pbystrup/EU1KY-Vector-Network-Analyzer/754926017-RF_FE_V3.png

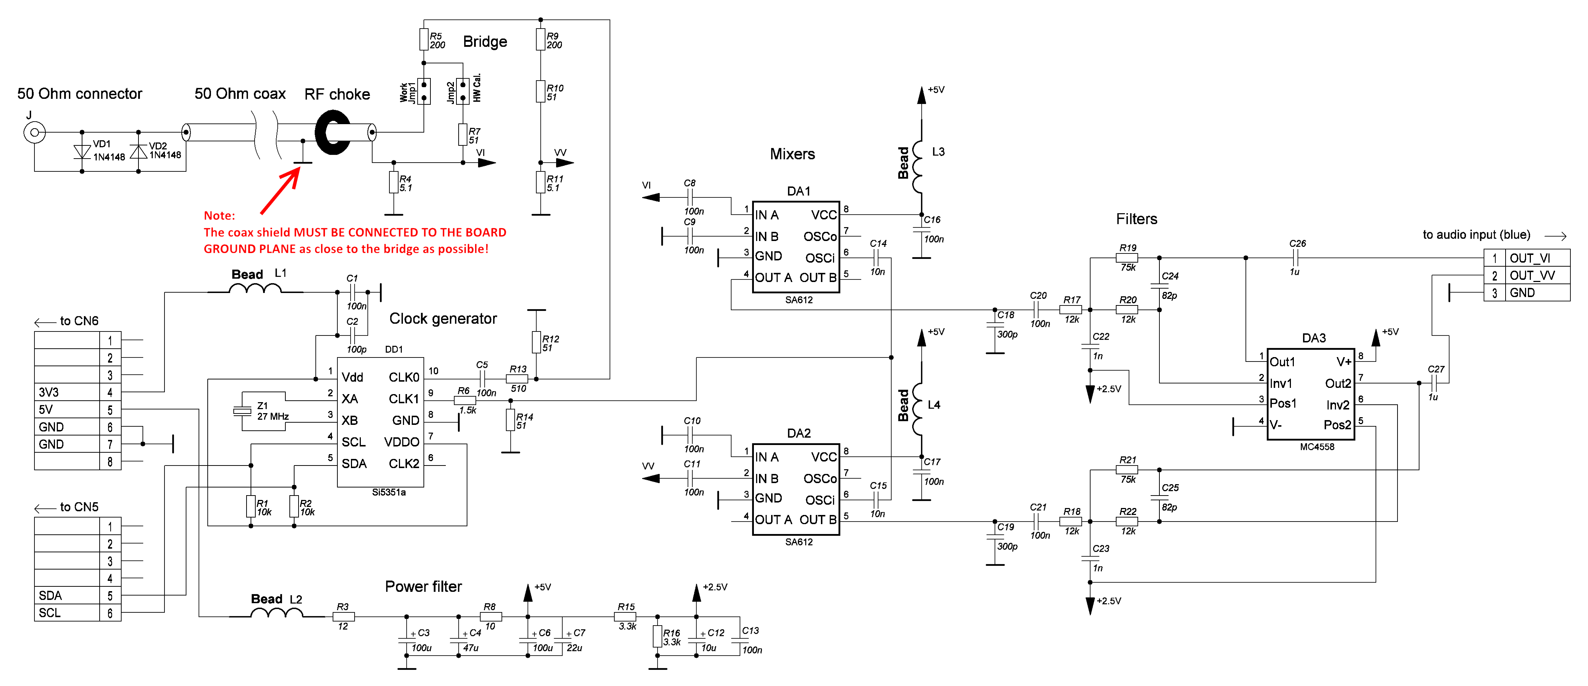
754926017-RF_FE_V3.png
