pbystrup/EU1KY-Vector-Network-Analyzer/EU1KY_V3_assy.gif

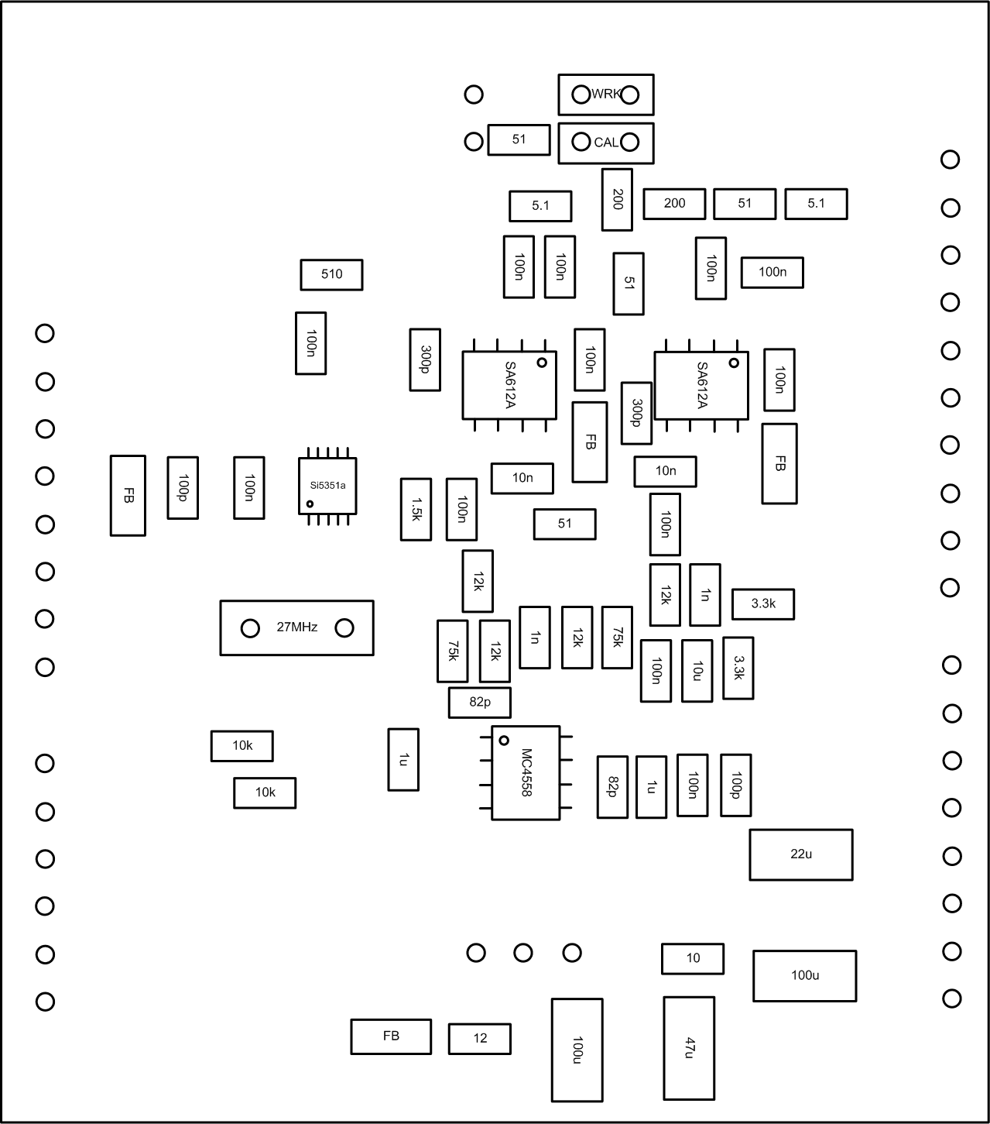
EU1KY_V3_assy.gif
