pbystrup/EU1KY-Vector-Network-Analyzer/RF_FE_V3  by YL2GL no trueholecaps xy all805 BOM.xlsx

BOM
Manufacturer | Manufacturer Part Number | Designator | Qty | Description | Case | SMD ,BGA,LLC(QFN),OR TH | Top/Bottom | points | Total points | Notes | Comments
AVX Corporation | 08055C104KAT2A | C1, C5, C8, C9, C10, C11, C13, C16, C17, C20, C21, C28 | 12 | 100nF,50V,10%,X7R,0805 | 0805 | SMD | Top | 2 | 24
AVX Corporation | 08055A101JAT2A | C2, C29 | 2 | 100pF,50V,5%,C0G,0805 | 0805 | SMD | Top | 2 | 4
AVX Corporation | TAJB107M010RNJ | C3, C6 | 2 | 100uF,10V,20%,1210(B) | 1210(B) | SMD | Top | 2 | 4
AVX Corporation | TAJB476M010RNJ | C4 | 1 | 47uF,10V,20%,1210(B) | 1210(B) | SMD | Top | 2 | 2
AVX Corporation | TAJB226M010RNJ | C7 | 1 | 22uF,10V,20%,1210(B) | 1210(B) | SMD | Top | 2 | 2
MULTICOMP | MC0805X106K100CT | C12 | 1 | 10uF,10V,10%,X5R,0805 | 0805 | SMD | Top | 2 | 2
AVX Corporation | 08055C103KAT2A | C14, C15 | 2 | 10nF,50V,10%,X7R,0805 | 0805 | SMD | Top | 2 | 4
AVX Corporation | 08055A331JAT2A | C18, C19 | 2 | 330pF,50V,5%,C0G,0805 | 0805 | SMD | Top | 2 | 4
AVX Corporation | 08055C102KAT2A | C22, C23 | 2 | 1nF,50V,10%,X7R,0805 | 0805 | SMD | Top | 2 | 4 | Please kindly check it should be 10nF or 1nF.
AVX Corporation | 08055A820JAT2A | C24, C25 | 2 | 82pF,50V,5%,C0G,0805 | 0805 | SMD | Top | 2 | 4
AVX Corporation | 08055C105KAT2A | C26, C27 | 2 | 1uF,50V,10%,X7R,0805 | 0805 | SMD | Top | 2 | 4
NXP Semiconductors | SA612AD/01,118 | DA1, DA2 | 2 | SA612AD/01,118,8-SO | 8-SO | SMD | Top | 8 | 16 | OK?
STMicroelectronics | MC4558CDT | DA3 | 1 | MC4558CDT,SO-8 | SO-8 | SMD | Top | 8 | 8
Silicon Laboratories | SI5351A-B-GT | DD1 | 1 | SI5351A-B-GT,MSOP-10 | MSOP-10 | SMD | Top | 10 | 10
Fair-Rite | 2508056017Y2 | L1, L2, L3, L4 | 4 | 600R,2A,0805 | 0805 | SMD | Top | 2 | 8
MULTICOMP | MCWR08X1002FTL | R1, R2 | 2 | 10K,1%,1/8W,0805 | 0805 | SMD | Top | 2 | 4
Panasonic | ERJ-P06J120V | R3 | 1 | 12R,5%,1/2W,0805 | 0805 | SMD | Top | 2 | 2 | OK?
MULTICOMP | MCWR08W5R10FTL | R4, R11 | 2 | 5.1R,1%,1/8W,0805 | 0805 | SMD | Top | 2 | 4
MULTICOMP | MCWR08X2000FTL | R5, R9 | 2 | 200R,1%,1/8W,0805 | 0805 | SMD | Top | 2 | 4
MULTICOMP | MCWR08X1501FTL | R6 | 1 | 1.5K,1%,1/8W,0805 | 0805 | SMD | Top | 2 | 2 | Please kindly check it should be 1 or 2.
MULTICOMP | MCWR08X51R0FTL | R7, R10, R12, R14 | 4 | 51R,1%,1/8W,0805 | 0805 | SMD | Top | 2 | 8
Panasonic | ERJ-P06F10R0V | R8 | 1 | 10R,1%,1/2W,0805 | 0805 | SMD | Top | 2 | 2 | OK?
MULTICOMP | MCWR08X5100FTL | R13 | 1 | 510R,1%,1/8W,0805 | 0805 | SMD | Top | 2 | 2
MULTICOMP | MCWR08X3301FTL | R15, R16 | 2 | 3.3K,1%,1/8W,0805 | 0805 | SMD | Top | 2 | 4
MULTICOMP | MCWR08X1202FTL | R17, R18, R20, R22 | 4 | 12K,1%,1/8W,0805 | 0805 | SMD | Top | 2 | 8
MULTICOMP | MCWR08X7502FTL | R19, R21 | 2 | 75K,1%,1/8W,0805 | 0805 | SMD | Top | 2 | 4
TXC Corporation | 9B-27.000MEEJ-B | X1 | 1 | 27MHz,18pF,HC-49/US | HC-49/US | TH | Bottom | 2 | 2
