pbystrup/EU1KY-Vector-Network-Analyzer/(list of files, drawings)

Other design files:
RF_FE_V3 by YL2GL no trueholecaps xy all805.lay6
RF_FE_V3%20%28by%20YL2GL%29.lay6
RF_FE_V3.lay6
